soloautomations/Ultrasound/Amplifier.png

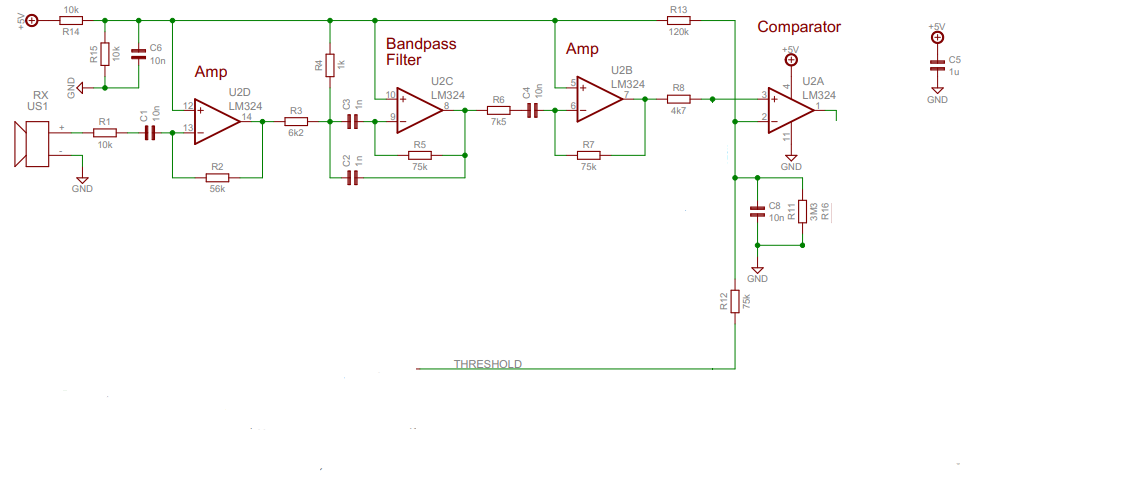
Amplifier.png
