soloautomations/Ultrasound/main/BOM.csv

Comment | Description | Designator | Footprint | LibRef | Quantity
0.1uF | Capacitor | C1, C2, C4, C15, C17, C18, C20, C21, C22, C24, C25 | 1C10X7R104K050B | Cap_Disc_TH | 11
22pF | Capacitor | C3, C5 | 1C10X7R104K050B | Cap_Disc_TH | 2
C10uF | Capacitor Polarised | C6, C7, C9, C13 | CAPPRD250W50D680H1250 | C10uF_ThruHole | 4
0.1uF | Capacitor | C8, C10, C14 | RESC3216X75N | C1206 | 3
1000UF_25V | Capacitor Polarised | C11, C12 | CAPPRD500W60D1300H2650 | C1000UF_25V | 2
0.01uF | Capacitor | C16, C19, C23 | 1C10X7R104K050B | Cap_Disc_TH | 3
1N4007 | Diode | D1, D2, D3, D4 | DIOAD1165W56L425D185 | 1N4148 | 4
FR107 | Diode | D5 | DIOAD1165W56L425D185 | 1N4148 | 1
Header 4 | Header, 4-Pin | P1 | HDR1X4 | Header 4 | 1
Header 2 | Header, 2-Pin | P2 | HDR1X2 | Header 2 | 1
Header 16 | Header, 16-Pin | P3 | HDR1X16 | Header 16 | 1
Header 3 | Header, 3-Pin | P4 | HDR1X3 | Header 3 | 1
PBT2 | Connector | P5 | TB00750802BE | PBT2 | 1
IRF9540 | MOSFET (P-Channel) | Q1 | TO254P465X1024X2050-3P | IRF9540 | 1
Res1 | Resistor | R1, R4, R7, R8, R10, R11, R12, R13, R14, R15 | AXIAL-0.3 | Res1 | 10
2.2K | Resistor | R2 | RESC3216X75N | R1206 | 1
8.2K | Resistor | R3 | RESC3216X75N | R1206 | 1
47E | Resistor | R5 | RESC3216X75N | R1206 | 1
10K | Resistor | R6 | RESC3216X75N | R1206 | 1
1K | Resistor | R9 | RESC3216X75N | R1206 | 1
SW-SPDT | SPDT Subminiature Toggle Switch, Right Angle Mounting, Vertical Actuation | S1 | TL36WW15050 | SW-SPDT | 1
SW_2PIN | Switch (2-Pin Push) | S2 | FSM2JRT | SW_2PIN | 1
Socket | Socket | TP1, TP2, TP3, TP4, TP5 | PIN1 | Socket | 5
PIC16F887 | Integrated Circuit | U1 | DIP1550W56P254L5219H483Q40N | PIC16F877A-E_P | 1
LM7912 | Integrated Circuit | U2 | TO254P470X1016X2019-3P | LM7915CT | 1
LM7805 | Integrated Circuit | U3 | TO254P470X1028X1955-3P | LM7815CT | 1
LM7812 | Integrated Circuit | U4 | TO254P470X1028X1955-3P | LM7815CT | 1
LM741 | Integrated Circuit | U5, U6, U7 | DIP794W53P254L959H508Q8N | LM741_DIP | 3
RPot | Potentiometer | VR1 | VR5 | RPot | 1
20Mhz | Crystal or Oscillator | X1 | 9B112896MEEJB | Crystal_ThruHole | 1
4.7V | Zener Diode | Z1 | DIODE-0.7 | D Zener | 1
