soloautomations/Ultrasound/main/main.pdf

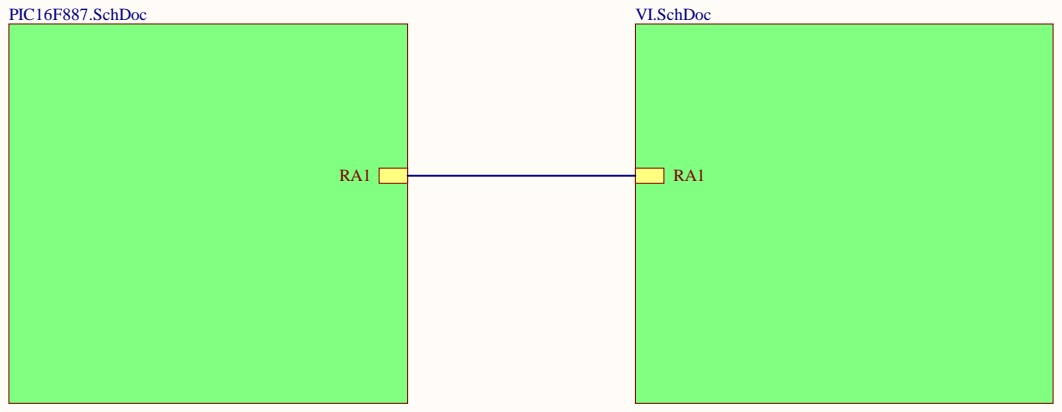
[picture p11: page 1]

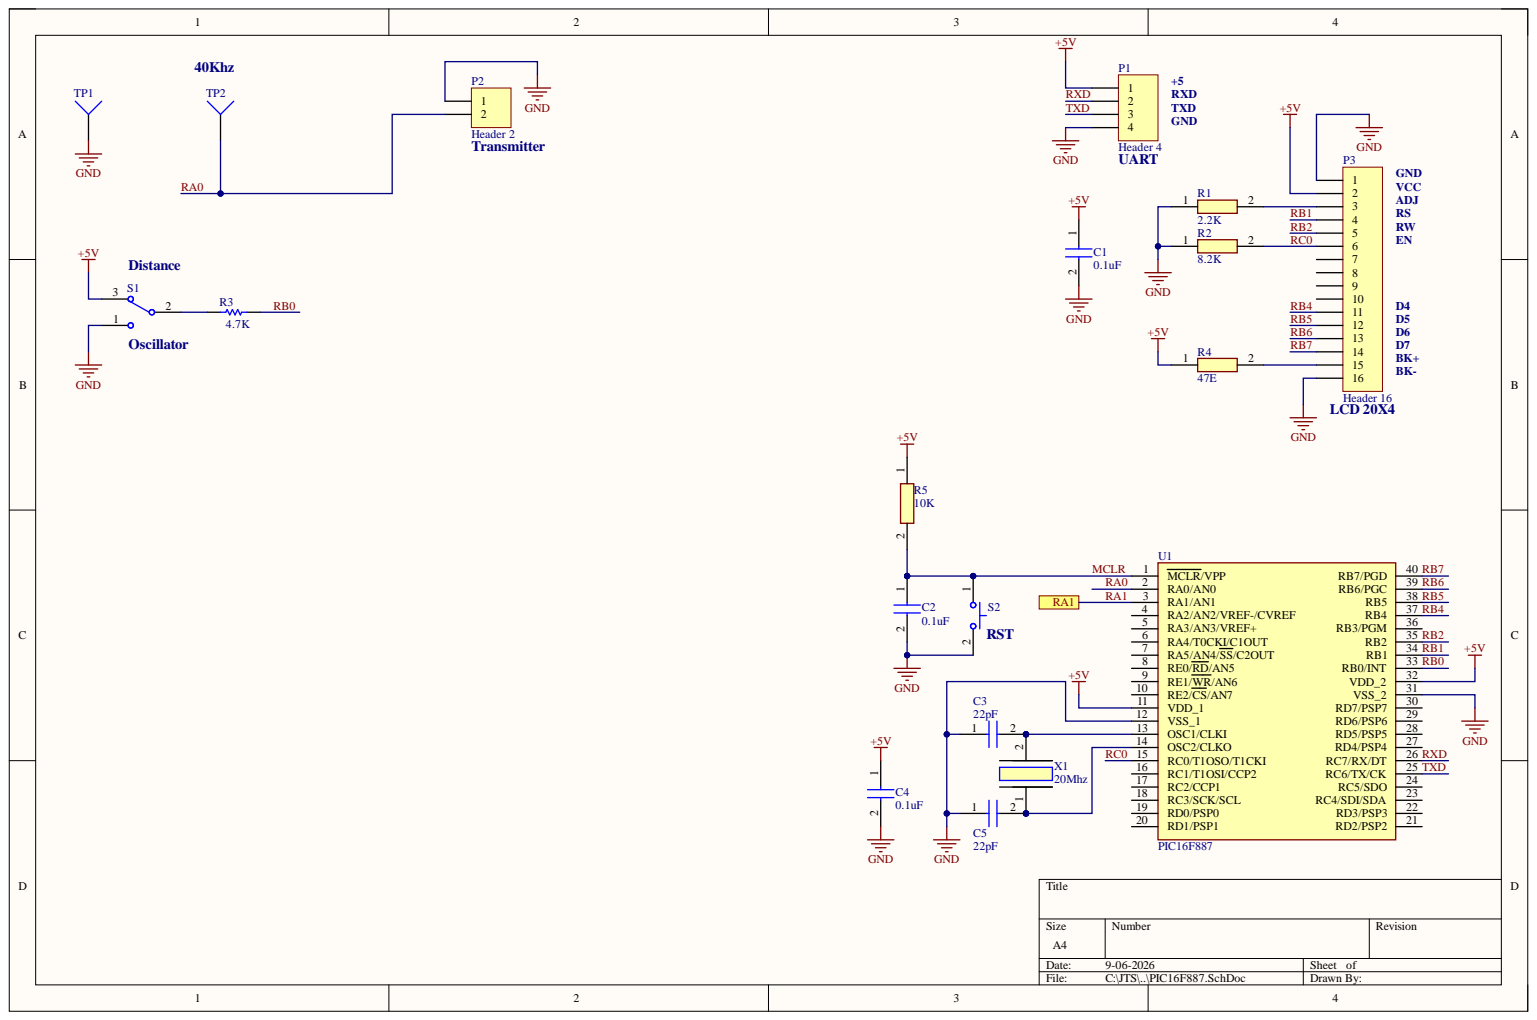
[picture p12: page 2]

1 1 | | 3 0
1 2 | | 2 9

1 4
RC0 | 1 5

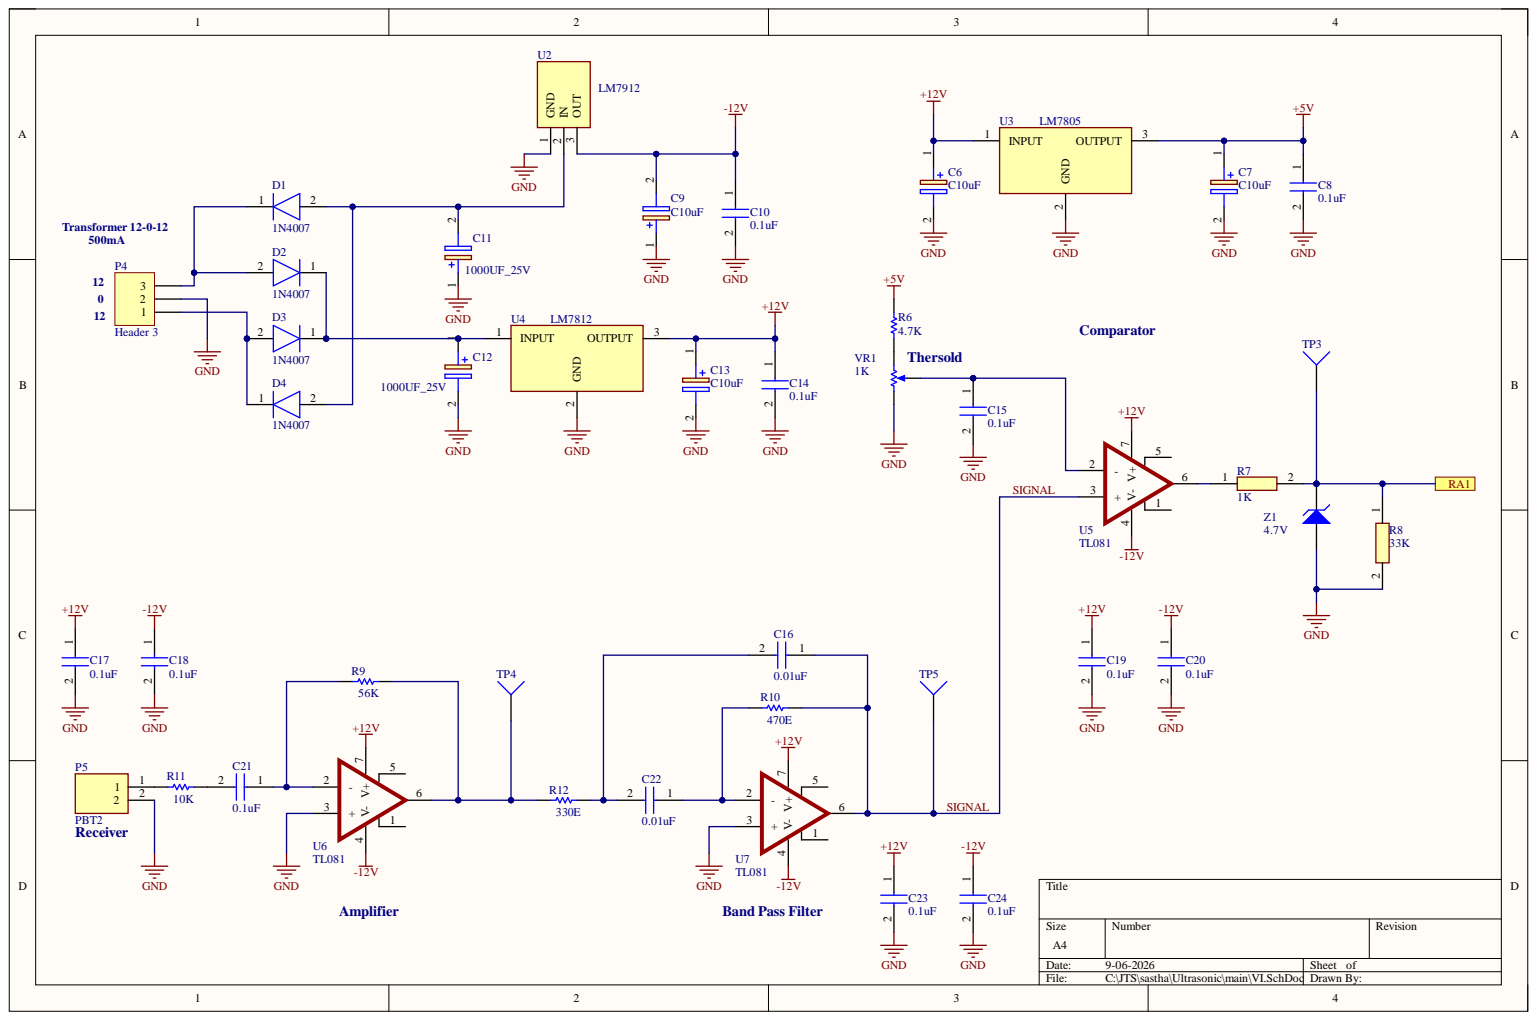
[picture p13: page 3]
