soloautomations/Ultrasound/(list of files, drawings)

Other design files:
main/main.PrjPcb
main/main.SchDoc
main/PIC16F887.SchDoc
main/VI.SchDoc
